movuino/base-shield--kicad/_doc/Movuino_shematic.png

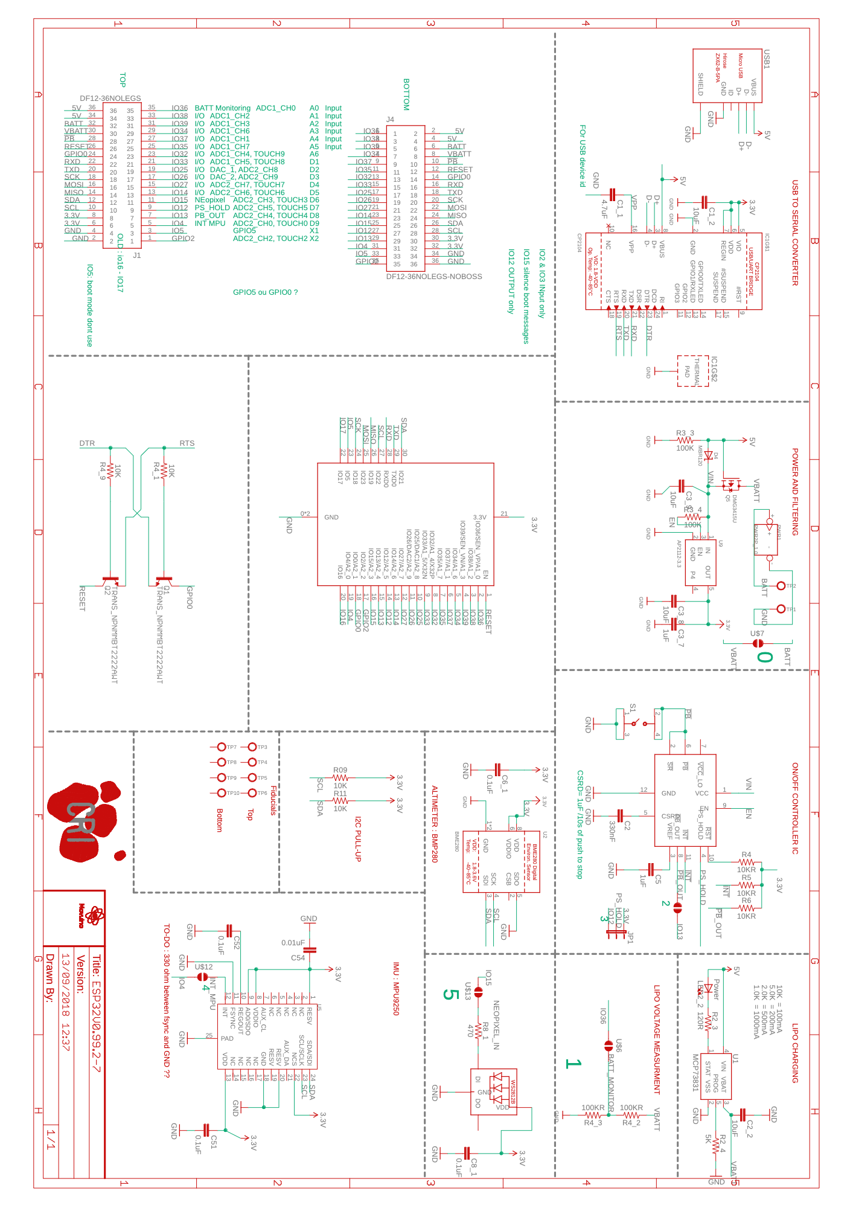
_doc/Movuino_shematic.png
