movuino/base-shield--kicad/(commit log)

2022-04-14 Init electronic ShieldPressure
    [MovuinoShieldPressure-B_Cu.gbl, MovuinoShieldPressure-B_Mask.gbs, MovuinoShieldPressure-B_SilkS.gbo, MovuinoShieldPressure-Edge_Cuts.gko, MovuinoShieldPressure-F_Cu.gtl, MovuinoShieldPressure-F_Mask.gts, MovuinoShieldPressure-F_SilkS.gto, MovuinoShieldPressure-NPTH.drl]
2022-04-14 Init electronic PressureConnector
    [Outline.dxf, SensitivePen_PressureConnector.kicad_pcb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]
2023-10-24 clean + comment
    [MovuinoBaseShield.kicad_pcb, MovuinoBaseShield.kicad_sch]
2023-10-27 add ground plane
    [MovuinoBaseShield.kicad_pcb]
